gamerpaddy/yamaha-ebike-battery-dongle/schematic/bottom.png

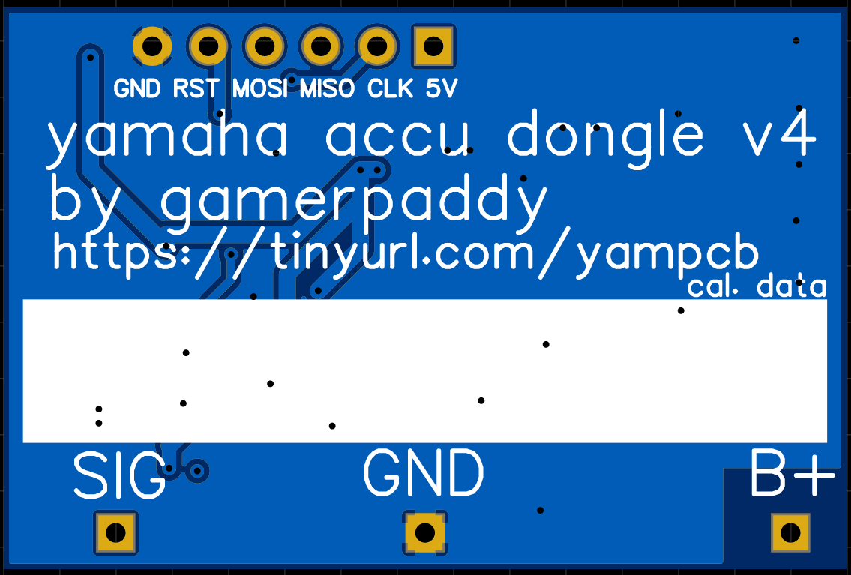
schematic/bottom.png
