gamerpaddy/yamaha-ebike-battery-dongle/schematic/front.png

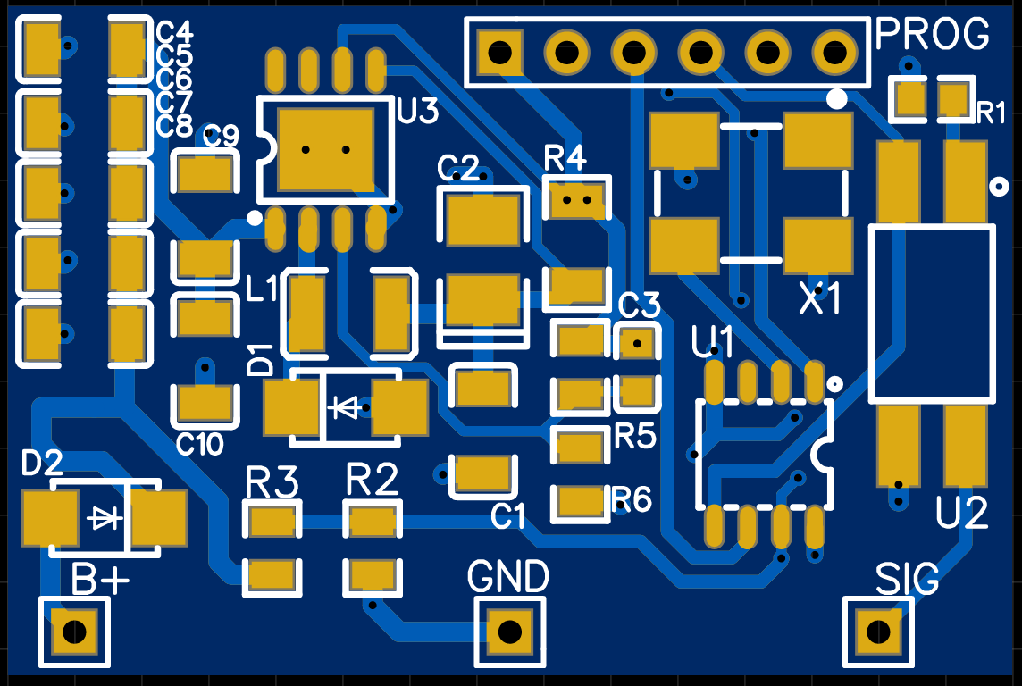
schematic/front.png
