gamerpaddy/yamaha-ebike-battery-dongle/schematic/pcb.png

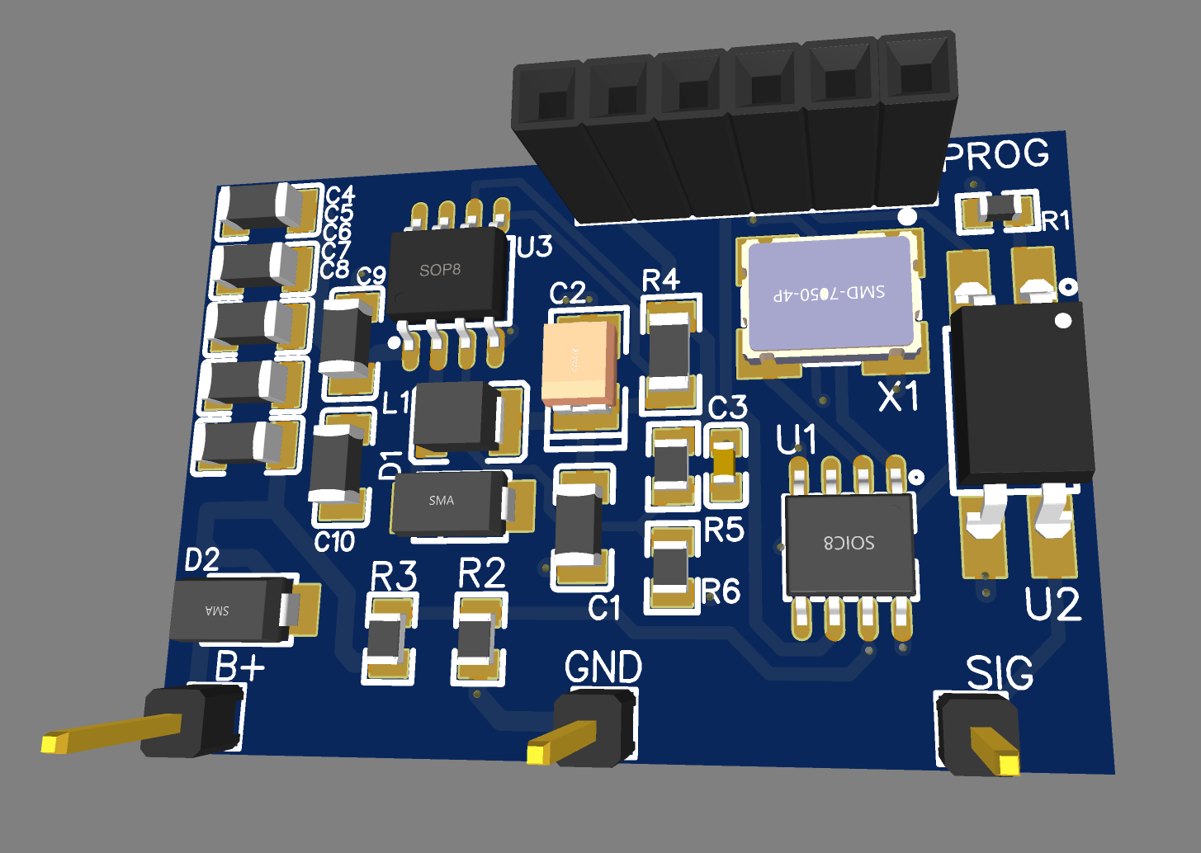
schematic/pcb.png
