gamerpaddy/yamaha-ebike-battery-dongle/schematic/BOM_PCB_2020-05-26_11-18-10_2021-08-31.csv

ID | Name | Designator | Footprint | Quantity
1 | 8MHz | X1 | OSC-SMD_4P-L7.0-W5.0-BL | 1
2 | 470 | R1 | R0603 | 1
3 | 3.3K | R6 | R0805 | 1
4 | PROG | PROG | HDR-F-2.54_1X6 | 1
5 | 100uH | L1 | L1210 | 1
6 | 33nF | C3 | C0603 | 1
7 | 0.1 | R4 | R1206 | 1
8 | PC817X1CSP9F(A ) | U2 | OPTO-SMD-4_L4.6-W6.5-P2.54-LS10.3-BL | 1
9 | HDR-M-2.54_1x1 | GND,SIG,B+ | HDR-M-2.54_1X1 | 3
10 | XL7045E1 | U3 | SOP-8_L4.9-W3.9-P1.27-LS6.0-BL-EP | 1
11 | 390K | R3 | R0805 | 1
12 | SS210 | D1,D2 | SMA_L4.3-W2.6-LS5.2-RD | 2
13 | 4.7uF | C5,C6,C7,C8,C9,C10 | C1206 | 6
14 | 1uF | C1 | C1206 | 1
15 | 100uF | C2 | CAP-SMD_L3.5-W2.8-R-RD | 1
16 | 10K | R2,R5 | R0805 | 2
17 | 100nF | C4 | C1206 | 1
18 | ATTINY13A-SSU | U1 | SOIC-8_L4.9-W3.9-P1.27-LS6.0-BL | 1
