gamerpaddy/yamaha-ebike-battery-dongle/schematic/Schematic_yamaha accu dongle v4_2021-08-31.pdf

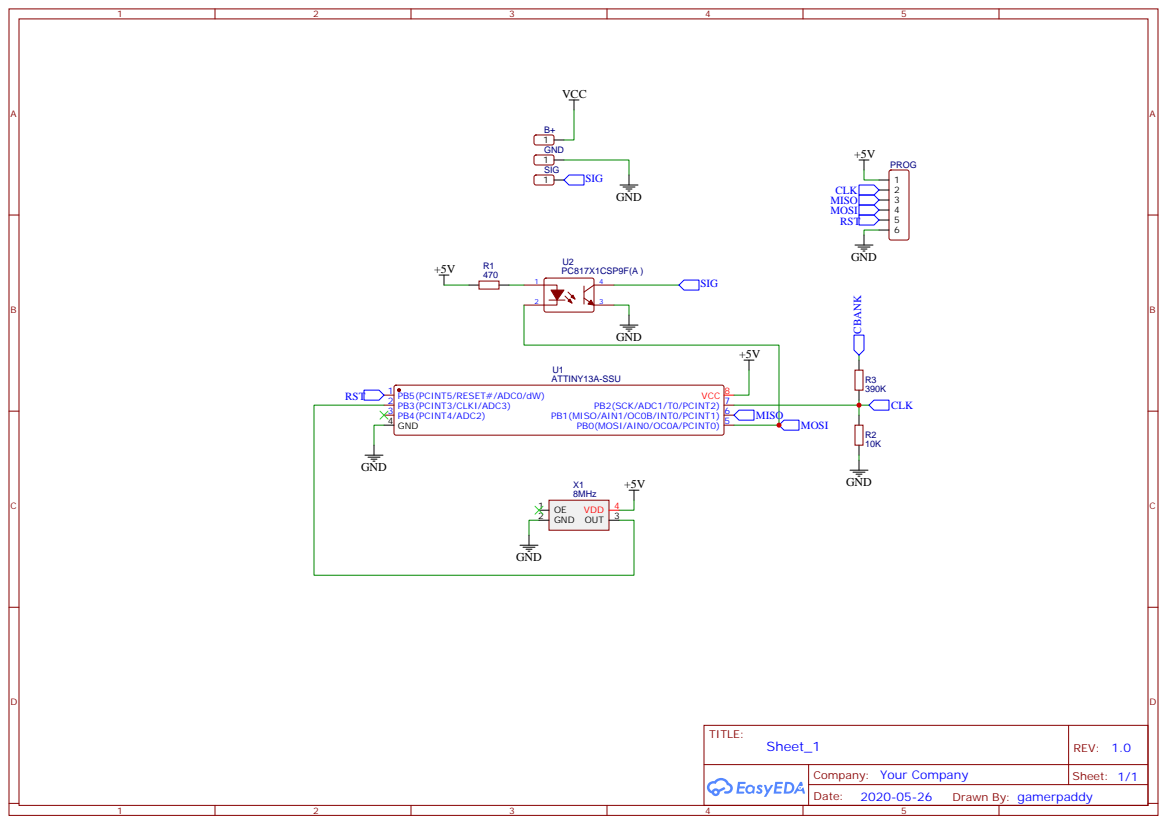
[picture p5: page 1]

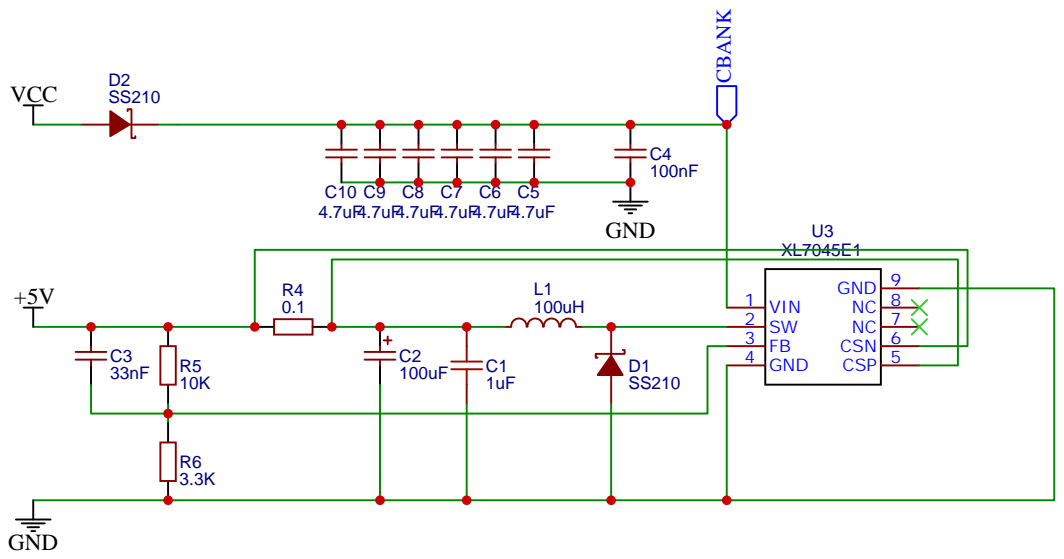
[picture p6: page 2]
