gamerpaddy/yamaha-ebike-battery-dongle/(list of files, drawings)

Other design files:
schematic/PCB_PCB_2020-05-26_11-18-10_2021-08-31.json
schematic/SCH_yamaha accu dongle v4_2021-08-31.json
